mwelling/pocketbone-kicad/README.md

# pocketbone-kicad
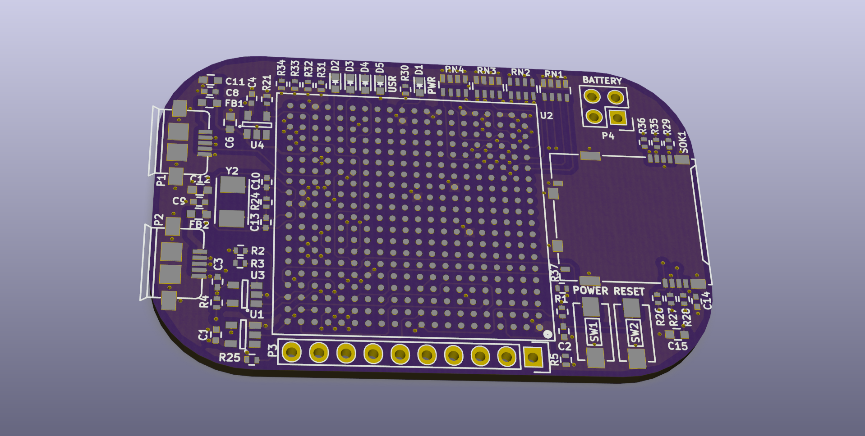
[picture p1: pocketbone-kicad.png]

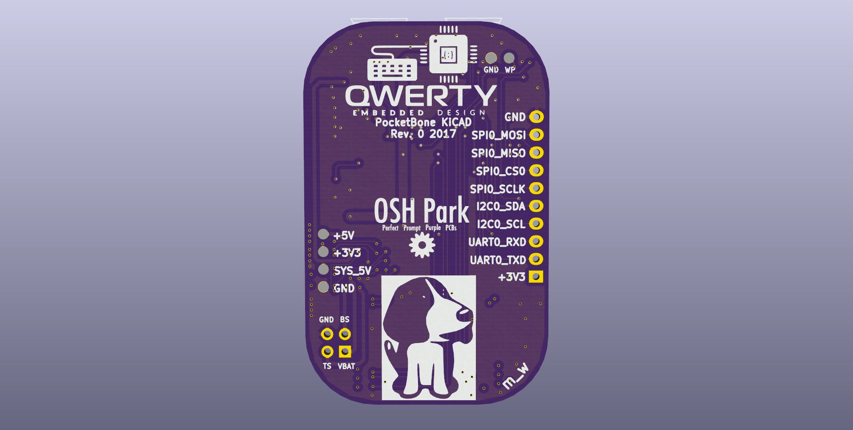
[picture p2: pocketbone-kicad-back.png]
