mwelling/pocketbone-kicad/pocketbone-kicad.pdf

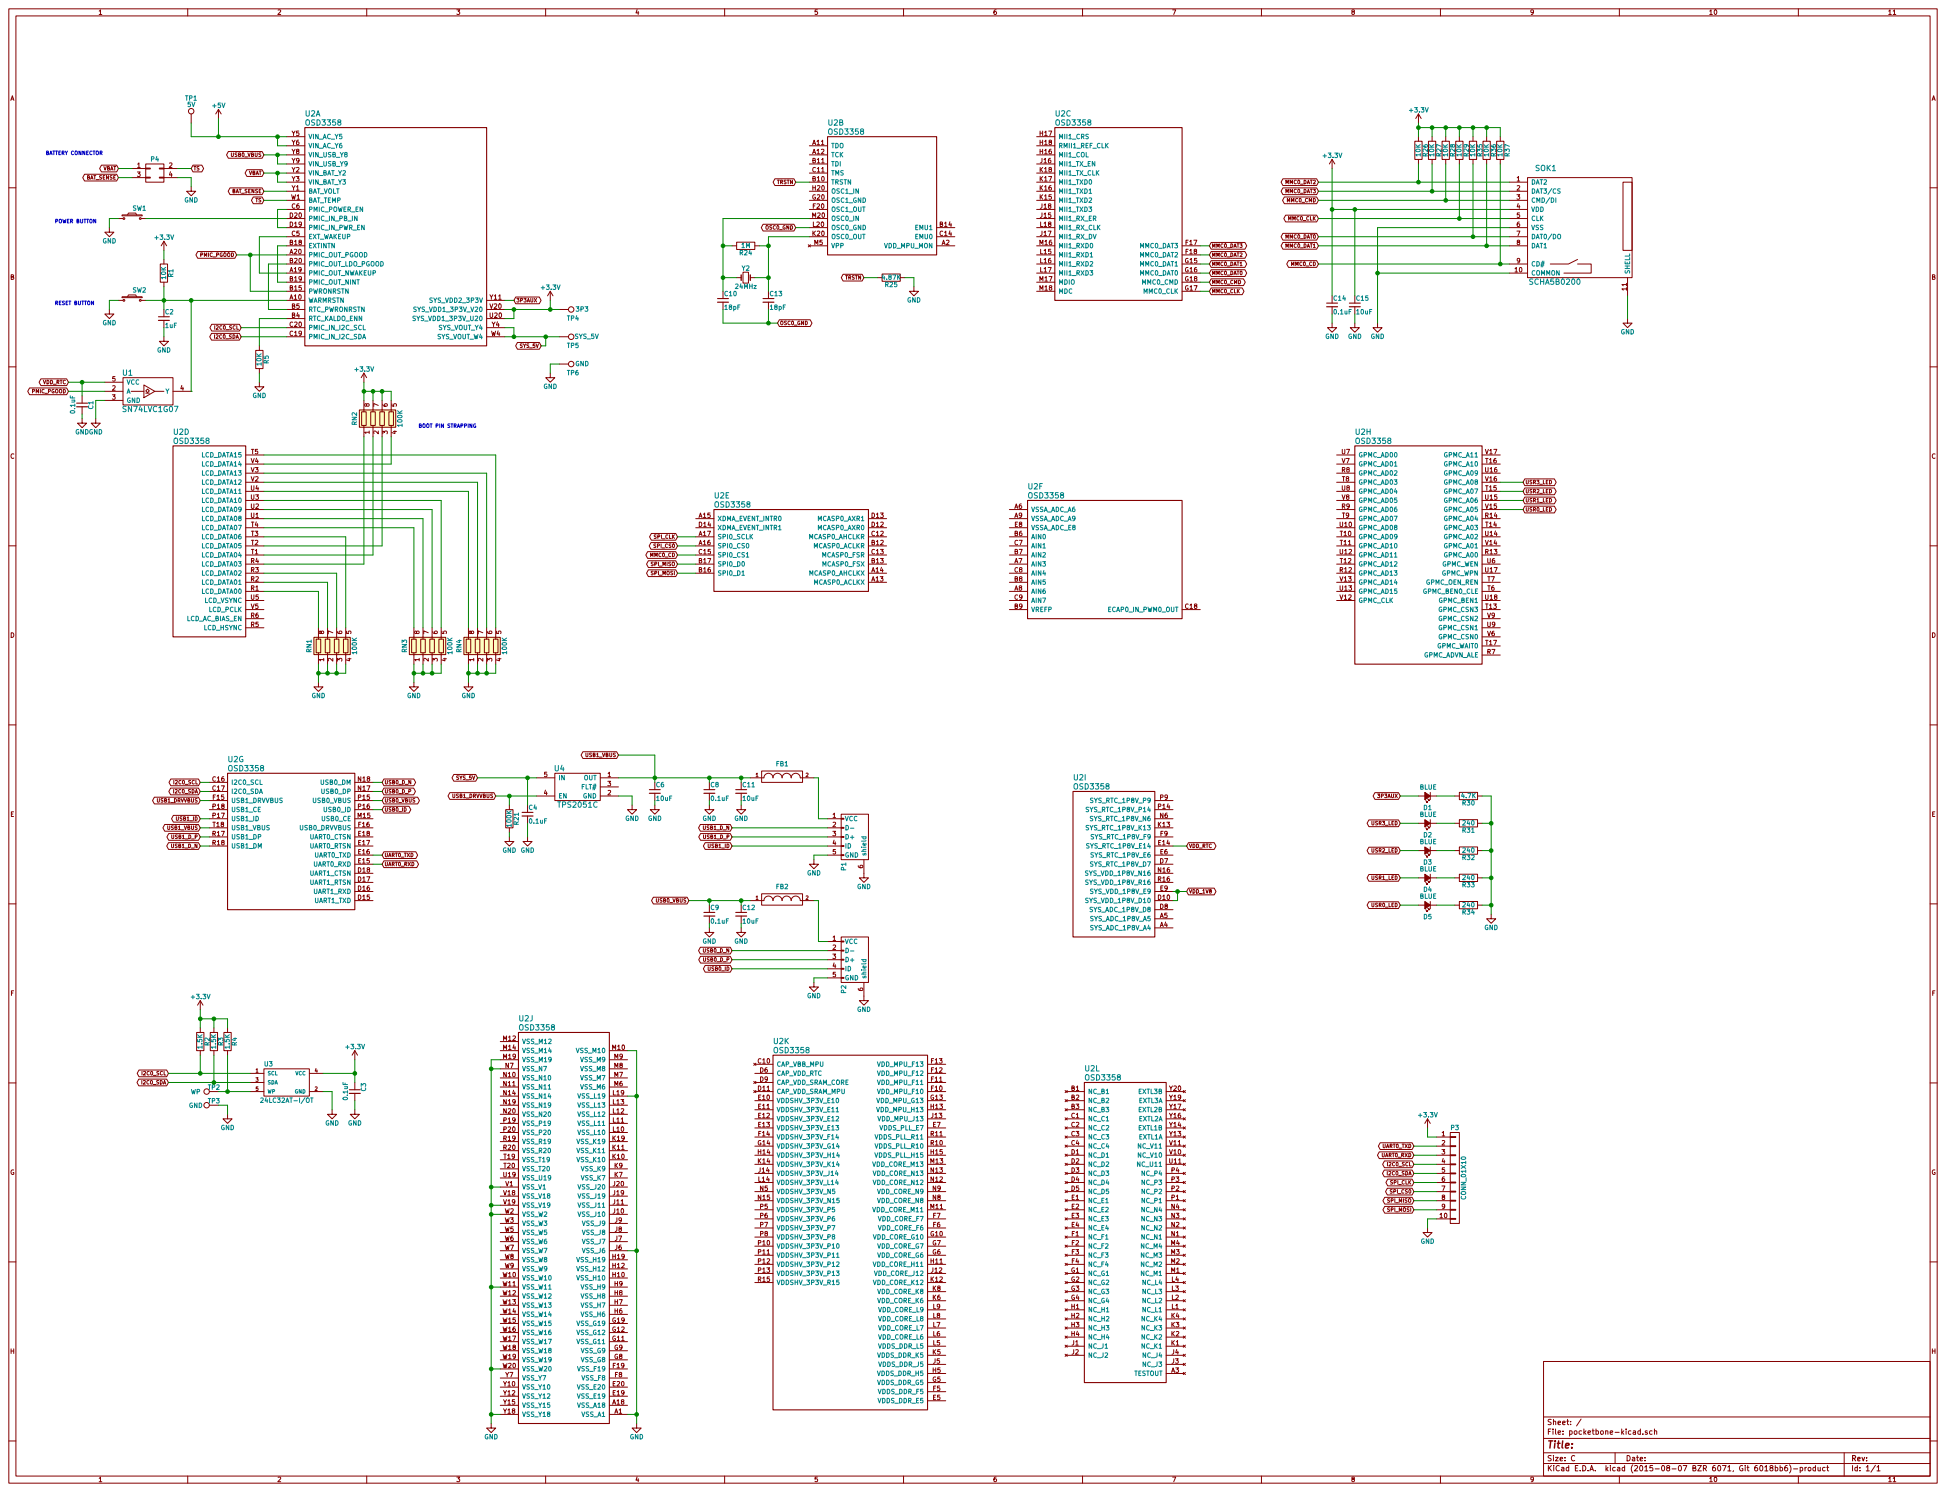
[picture p3: page 1]

File: pocketbone-kicad.sch Sheet: /
