mwelling/pocketbone-kicad/pocketbone-kicad.kicad_pcb

## KiCad design pocketbone-kicad.kicad_pcb (2017-03-28)

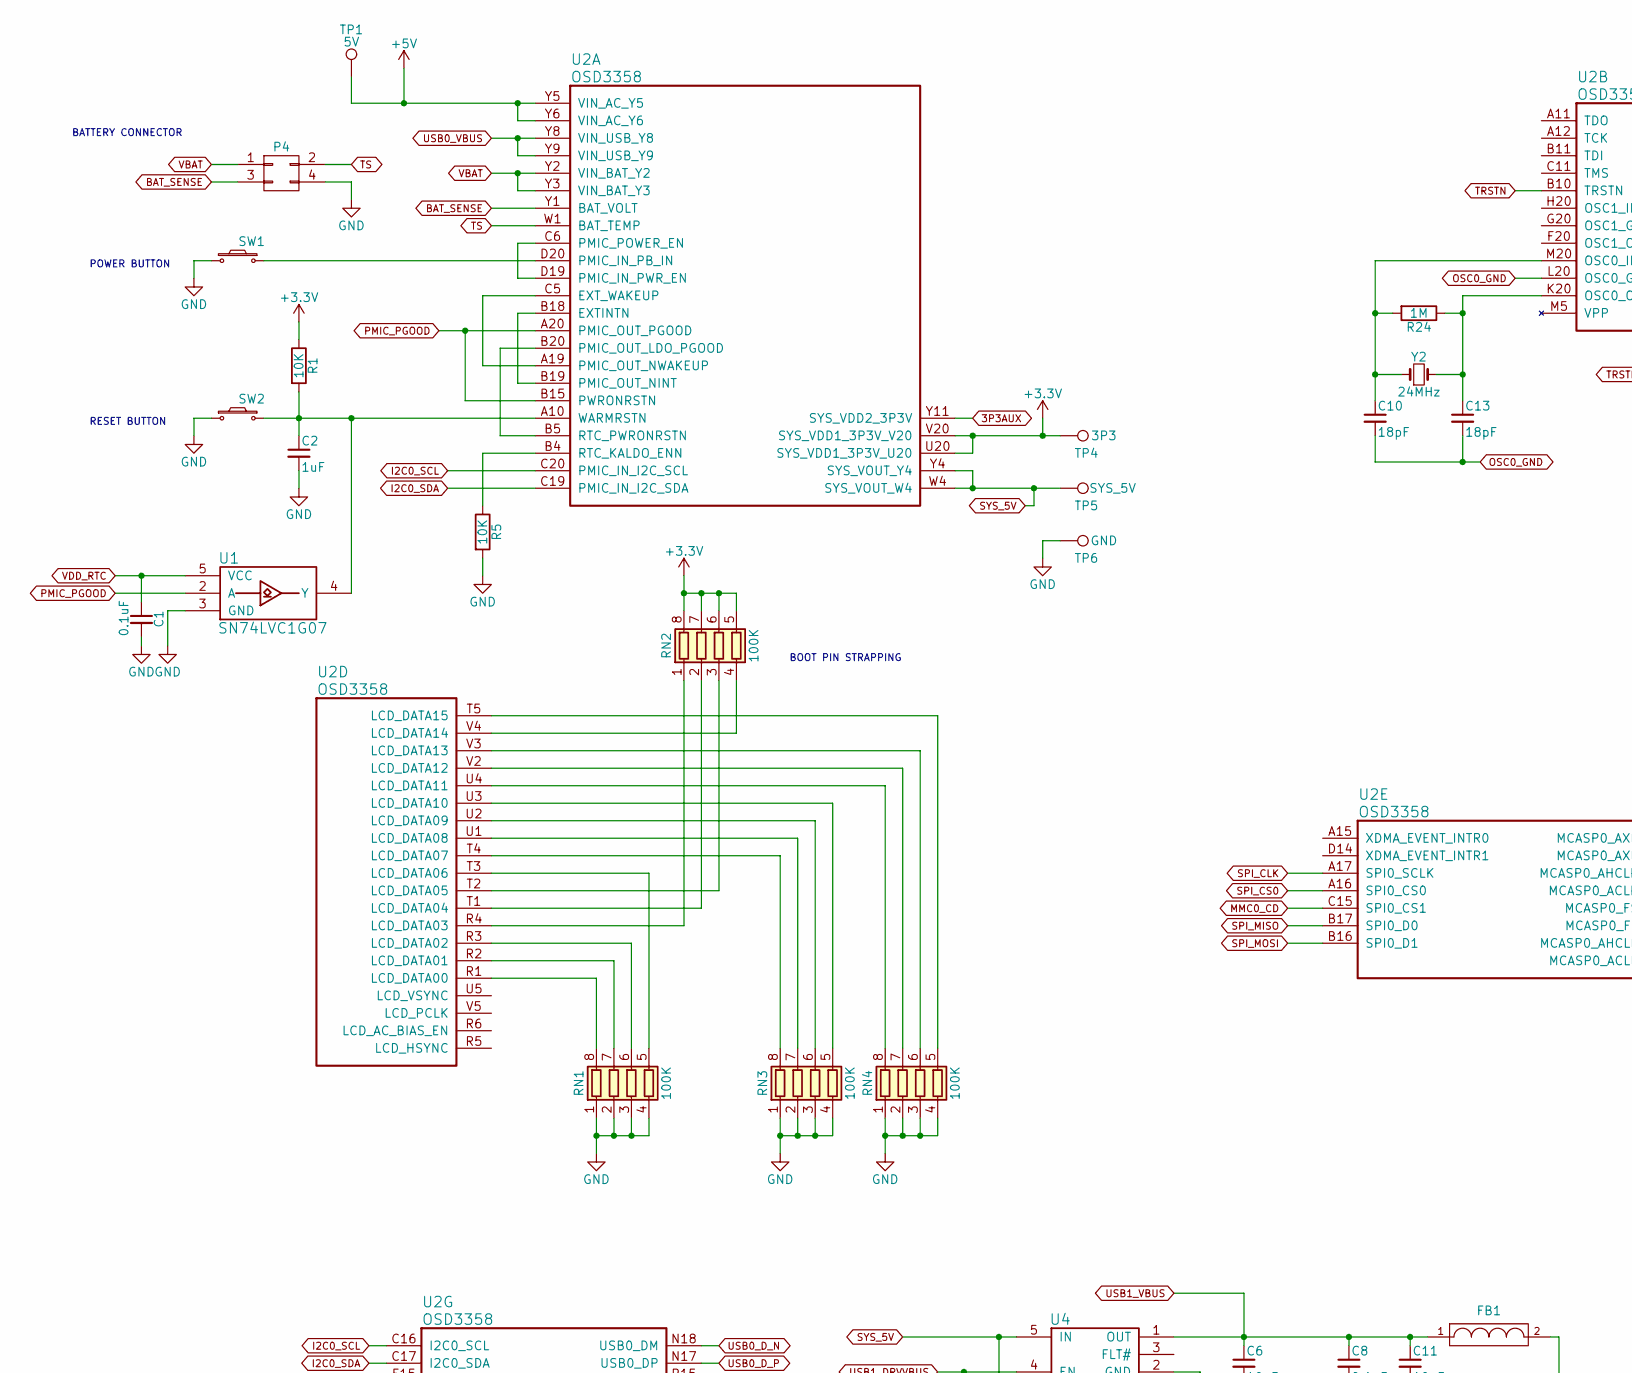
[picture p4: schematic pocketbone-kicad.sch, part in row 1, column 1]

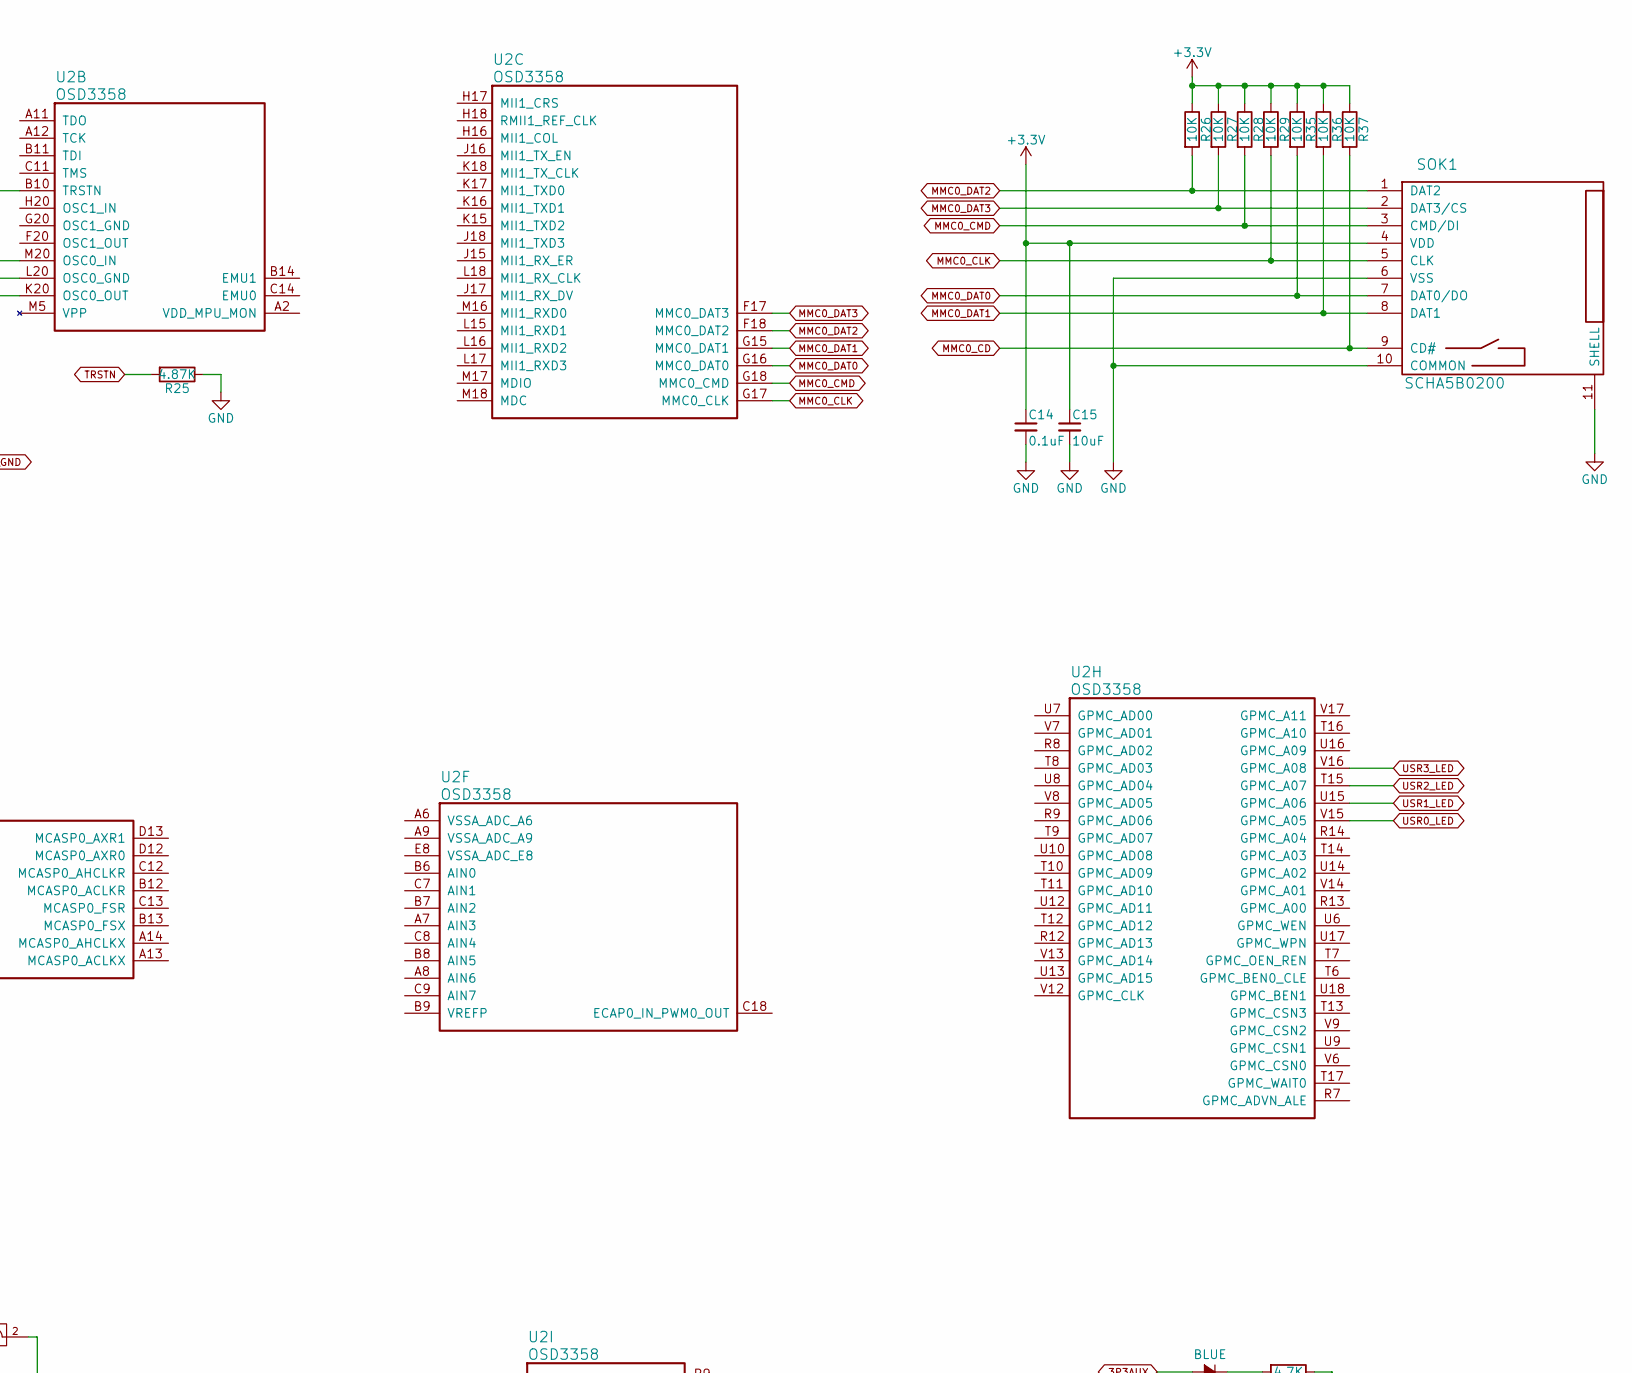
[picture p5: schematic pocketbone-kicad.sch, part in row 1, column 2]

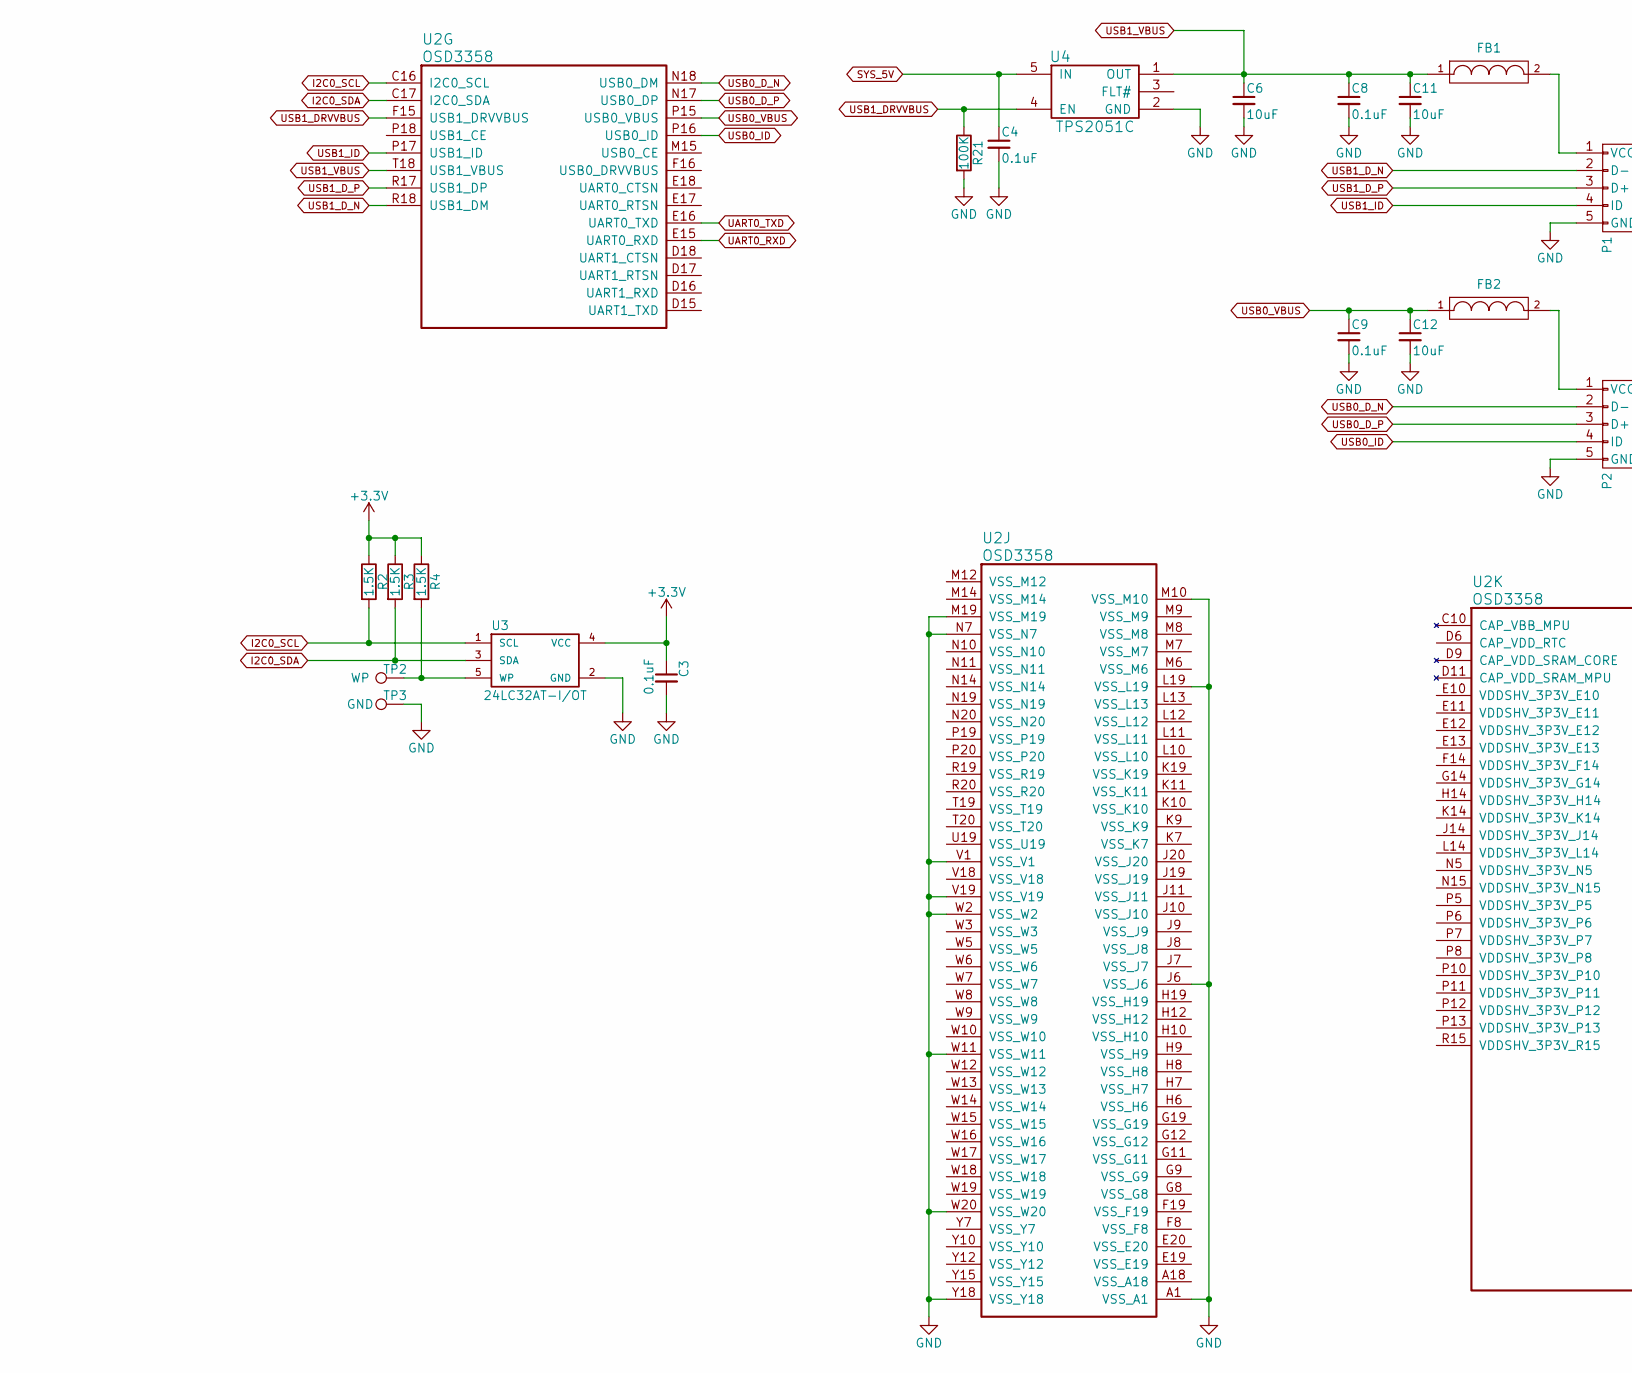
[picture p6: schematic pocketbone-kicad.sch, part in row 2, column 1]

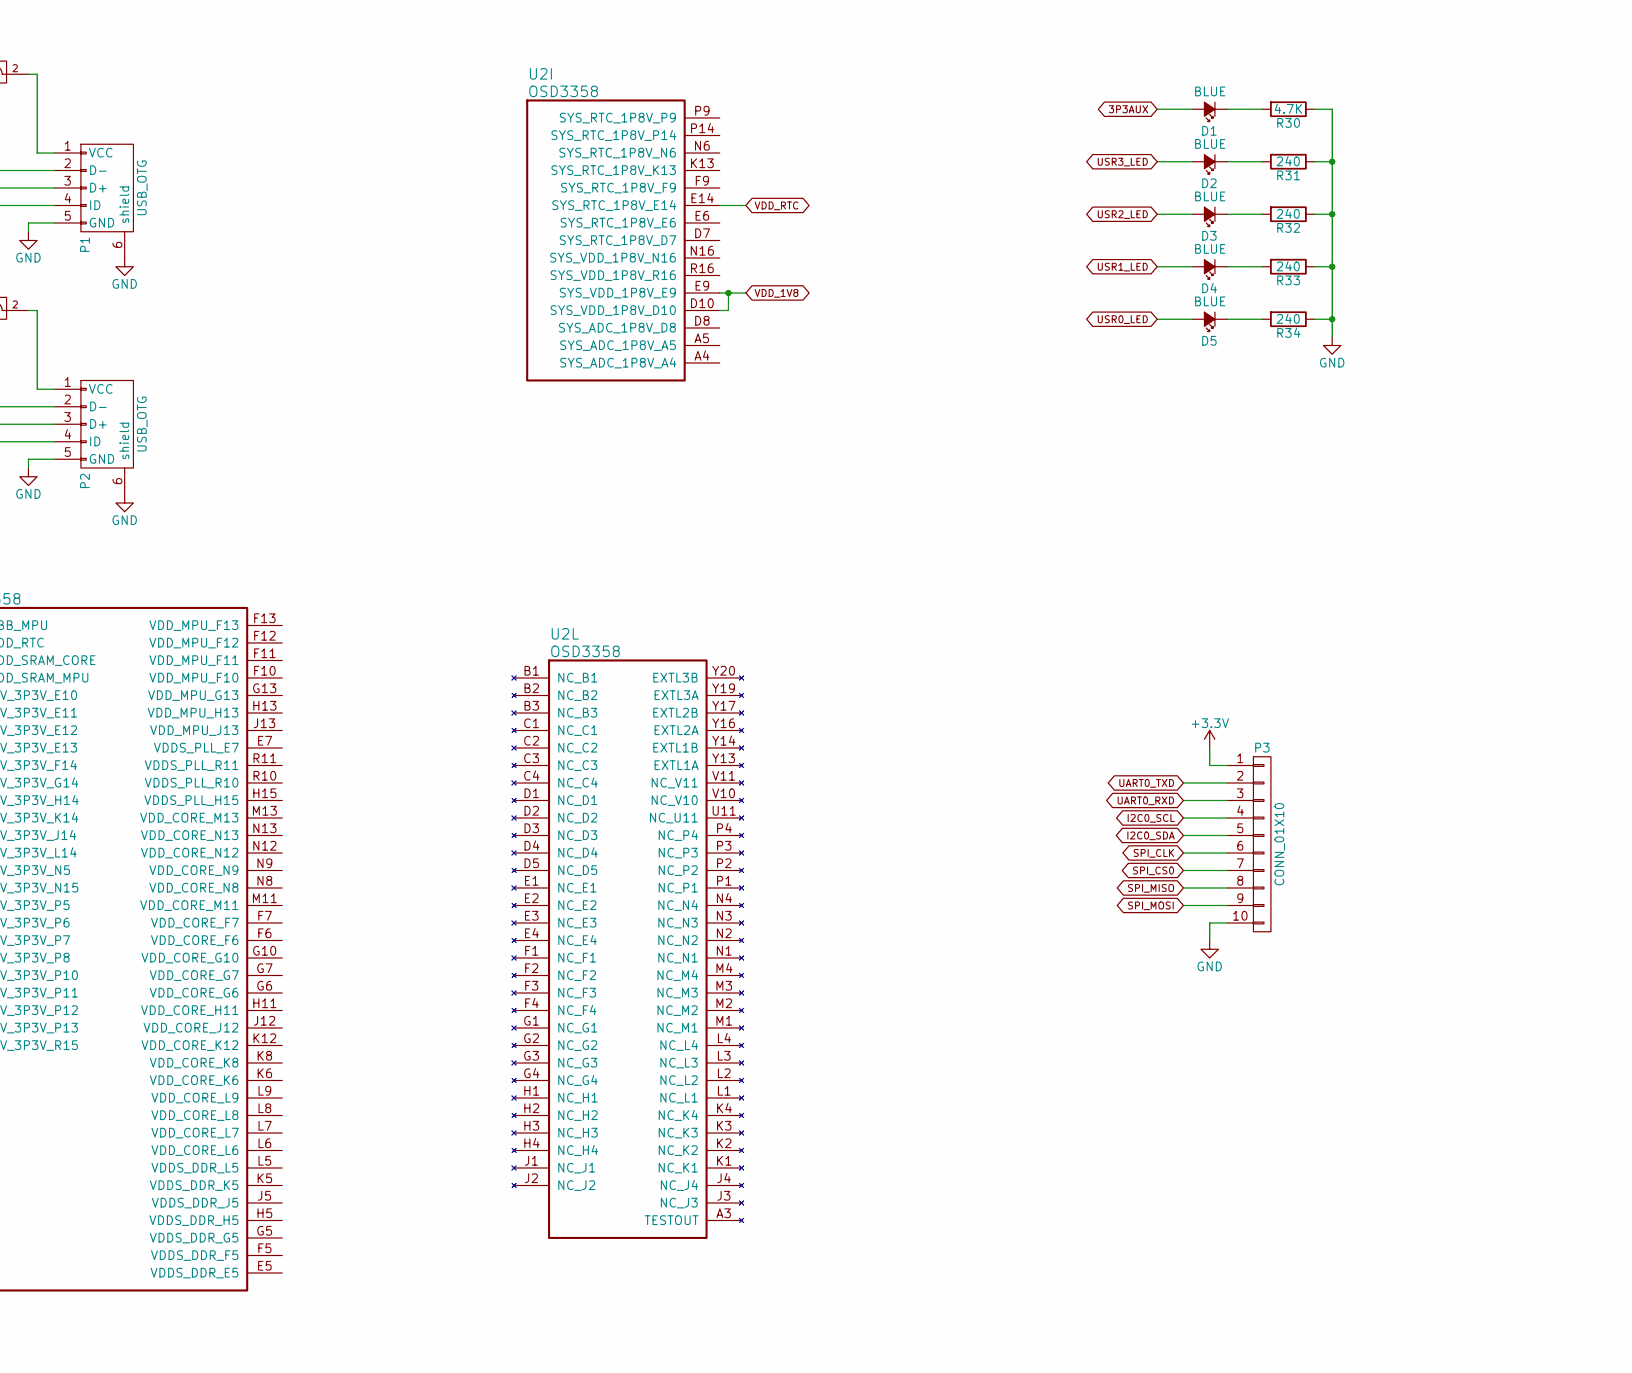
[picture p7: schematic pocketbone-kicad.sch, part in row 2, column 2]

Parts:
C1, C3, C4, C8, C9, C14: 0.1uF; C_0402
C2: 1uF; C_0402
C6, C11, C12, C15: 10uF; C_0603
C10, C13: 18pF; C_0402
D1, D2, D3, D4, D5: BLUE; LED-0603
FB1, FB2: FILTER; C_0603
P1, P2: USB_OTG; USB_MICRO_B_ST-USB-001E
P3: CONN_01X10; Socket_Strip_Straight_1x10
P4: CONN_02X02; Socket_Strip_Straight_2x02
R1, R5, R26, R27, R28, R29, R35, R36, R37: 10K; R_0402
R2, R3, R4: 1.5K; R_0402
R21: 100K; R_0402
R24: 1M; R_0402
R25: 4.87K; R_0402
R30: 4.7K; R_0402
R31, R32, R33, R34: 240; R_0402
RN1, RN2, RN3, RN4: 100K; R_Array_Concave_4x0603
SOK1: SCHA5B0200
SW1, SW2: SW_PUSH_SMALL_H; SW_SPST_EVQPE1
TP1: 5V; Measurement_Point_Round-SMD-Pad_Small
TP2: WP; Measurement_Point_Round-SMD-Pad_Small
TP3, TP6: GND; Measurement_Point_Round-SMD-Pad_Small
TP4: 3P3; Measurement_Point_Round-SMD-Pad_Small
TP5: SYS_5V; Measurement_Point_Round-SMD-Pad_Small
U1: SN74LVC1G07; SOT-23-5
U2: OSD3358; BGA-400-1-27mm
U3: 24LC32AT-I/OT; SOT-23-5
U4: TPS2051C; SOT-23-5
Y2: 24MHz; 445C33D24M00000

Connections:
3P3AUX: D1.2 (A), U2.Y11 (SYS_VDD2_3P3V)
+3V3: C3.1, C14.1, C15.1, P3.1, R1.1, R2.1, R3.1, R4.1, R26.1, R27.1, R28.1, R29.1, R35.1, R36.1, R37.1, RN2.5 (R4.2), RN2.6 (R3.2), RN2.7 (R2.2), RN2.8 (R1.2), SOK1.4 (VDD), TP4.1, U2.U20 (SYS_VDD1_3P3V_U20), U2.V20 (SYS_VDD1_3P3V_V20), U3.4 (VCC)
+5V: TP1.1, U2.Y5 (VIN_AC_Y5), U2.Y6 (VIN_AC_Y6)
BAT_SENSE: P4.3, U2.Y1 (BAT_VOLT)
GND: C1.2, C2.2, C3.2, C4.2, C6.2, C8.2, C9.2, C11.2, C12.2, C14.2, C15.2, P1.5 (GND), P1.6 (shield), P2.5 (GND), P2.6 (shield), P3.10, P4.4, R5.2, R21.2, R25.1, R30.1, R31.1, R32.1, R33.1, R34.1, RN1.1 (R1.1), RN1.2 (R2.1), RN1.3 (R3.1), RN1.4 (R4.1), RN3.1 (R1.1), RN3.2 (R2.1), RN3.3 (R3.1), RN3.4 (R4.1), RN4.1 (R1.1), RN4.2 (R2.1), RN4.3 (R3.1), RN4.4 (R4.1), SOK1.6 (VSS), SOK1.10 (COMMON), SOK1.11 (SHELL), SW1.1, SW2.1, TP3.1, TP6.1, U1.3 (GND), U2.A1 (VSS_A1), U2.J6 (VSS_J6), U2.L19 (VSS_L19), U2.M10 (VSS_M10), U2.M19 (VSS_M19), U2.N7 (VSS_N7), U2.V1 (VSS_V1), U2.V19 (VSS_V19), U2.W2 (VSS_W2), U2.W11 (VSS_W11), U2.W20 (VSS_W20), U2.Y18 (VSS_Y18), U3.2 (GND), U4.2 (GND)
I2C0_SCL: P3.4, R2.2, U2.C16 (I2C0_SCL), U2.C20 (PMIC_IN_I2C_SCL), U3.1 (SCL)
I2C0_SDA: P3.5, R3.2, U2.C17 (I2C0_SDA), U2.C19 (PMIC_IN_I2C_SDA), U3.3 (SDA)
MMC0_CD: R37.2, SOK1.9 (CD#), U2.C15 (SPI0_CS1)
MMC0_CLK: R29.2, SOK1.5 (CLK), U2.G17 (MMC0_CLK)
MMC0_CMD: R28.2, SOK1.3 (CMD/DI), U2.G18 (MMC0_CMD)
MMC0_DAT0: R35.2, SOK1.7 (DAT0/DO), U2.G16 (MMC0_DAT0)
MMC0_DAT1: R36.2, SOK1.8 (DAT1), U2.G15 (MMC0_DAT1)
MMC0_DAT2: R26.2, SOK1.1 (DAT2), U2.F18 (MMC0_DAT2)
MMC0_DAT3: R27.2, SOK1.2 (DAT3/CS), U2.F17 (MMC0_DAT3)
unnamed: C2.1, R1.2, SW2.2, U1.4 (Y), U2.A10 (WARMRSTN)
unnamed: C10.1, R24.2, U2.M20 (OSC0_IN), Y2.1
unnamed: C13.1, R24.1, U2.K20 (OSC0_OUT), Y2.2
unnamed: D1.1 (K), R30.2
unnamed: D2.1 (K), R31.2
unnamed: D3.1 (K), R32.2
unnamed: D4.1 (K), R33.2
unnamed: D5.1 (K), R34.2
unnamed: FB1.2, P1.1 (VCC)
unnamed: FB2.2, P2.1 (VCC)
unnamed: R4.2, TP2.1, U3.5 (WP)
unnamed: R5.1, U2.B4 (RTC_KALDO_ENN)
unnamed: RN1.5 (R4.2), U2.T3 (LCD_DATA06)
unnamed: RN1.6 (R3.2), U2.R3 (LCD_DATA02)
unnamed: RN1.7 (R2.2), U2.R2 (LCD_DATA01)
unnamed: RN1.8 (R1.2), U2.R1 (LCD_DATA00)
unnamed: RN2.1 (R1.1), U2.R4 (LCD_DATA03)
unnamed: RN2.2 (R2.1), U2.T1 (LCD_DATA04)
unnamed: RN2.3 (R3.1), U2.T2 (LCD_DATA05)
unnamed: RN2.4 (R4.1), U2.V4 (LCD_DATA14)
unnamed: RN3.5 (R4.2), U2.U3 (LCD_DATA10)
unnamed: RN3.6 (R3.2), U2.U2 (LCD_DATA09)
unnamed: RN3.7 (R2.2), U2.U1 (LCD_DATA08)
unnamed: RN3.8 (R1.2), U2.T4 (LCD_DATA07)
unnamed: RN4.5 (R4.2), U2.T5 (LCD_DATA15)
unnamed: RN4.6 (R3.2), U2.V3 (LCD_DATA13)
unnamed: RN4.7 (R2.2), U2.V2 (LCD_DATA12)
unnamed: RN4.8 (R1.2), U2.U4 (LCD_DATA11)
unnamed: SW1.2, U2.D20 (PMIC_IN_PB_IN)
unnamed: U2.A19 (PMIC_OUT_NWAKEUP), U2.C5 (EXT_WAKEUP)
unnamed: U2.B18 (EXTINTN), U2.B19 (PMIC_OUT_NINT)
unnamed: U2.B5 (RTC_PWRONRSTN), U2.B20 (PMIC_OUT_LDO_PGOOD)
unnamed: U2.C6 (PMIC_POWER_EN), U2.D19 (PMIC_IN_PWR_EN)
OSC0_GND: C10.2, C13.2, U2.L20 (OSC0_GND)
PMIC_PGOOD: U1.2 (A), U2.A20 (PMIC_OUT_PGOOD), U2.B15 (PWRONRSTN)
SPI_CLK: P3.6, U2.A17 (SPI0_SCLK)
SPI_CS0: P3.7, U2.A16 (SPI0_CS0)
SPI_MISO: P3.8, U2.B17 (SPI0_D0)
SPI_MOSI: P3.9, U2.B16 (SPI0_D1)
SYS_5V: C4.1, TP5.1, U2.W4 (SYS_VOUT_W4), U2.Y4 (SYS_VOUT_Y4), U4.5 (IN)
TRSTN: R25.2, U2.B10 (TRSTN)
TS: P4.2, U2.W1 (BAT_TEMP)
UART0_RXD: P3.3, U2.E15 (UART0_RXD)
UART0_TXD: P3.2, U2.E16 (UART0_TXD)
USB0_D_N: P2.2 (D-), U2.N18 (USB0_DM)
USB0_D_P: P2.3 (D+), U2.N17 (USB0_DP)
USB0_ID: P2.4 (ID), U2.P16 (USB0_ID)
USB0_VBUS: C9.1, C12.1, FB2.1, U2.P15 (USB0_VBUS), U2.Y8 (VIN_USB_Y8), U2.Y9 (VIN_USB_Y9)
USB1_DRVVBUS: R21.1, U2.F15 (USB1_DRVVBUS), U4.4 (EN)
USB1_D_N: P1.2 (D-), U2.R18 (USB1_DM)
USB1_D_P: P1.3 (D+), U2.R17 (USB1_DP)
USB1_ID: P1.4 (ID), U2.P17 (USB1_ID)
USB1_VBUS: C6.1, C8.1, C11.1, FB1.1, U2.T18 (USB1_VBUS), U4.1 (OUT)
USR0_LED: D5.2 (A), U2.V15 (GPMC_A05)
USR1_LED: D4.2 (A), U2.U15 (GPMC_A06)
USR2_LED: D3.2 (A), U2.T15 (GPMC_A07)
USR3_LED: D2.2 (A), U2.V16 (GPMC_A08)
VBAT: P4.1, U2.Y2 (VIN_BAT_Y2), U2.Y3 (VIN_BAT_Y3)
VDD_1V8: U2.D10 (SYS_VDD_1P8V_D10), U2.E9 (SYS_VDD_1P8V_E9)
VDD_RTC: C1.1, U1.5 (VCC), U2.E14 (SYS_RTC_1P8V_E14)

Notes on the sheet:
POWER BUTTON
RESET BUTTON
BOOT PIN STRAPPING
BATTERY CONNECTOR

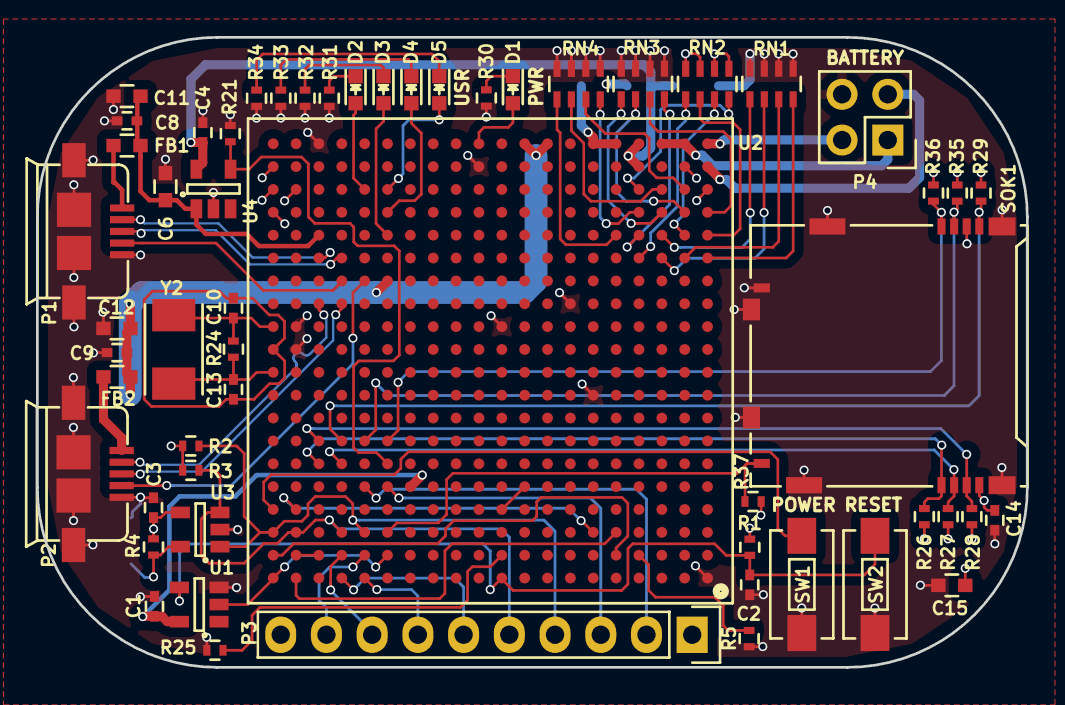
[picture p8: board pocketbone-kicad.kicad_pcb from above]

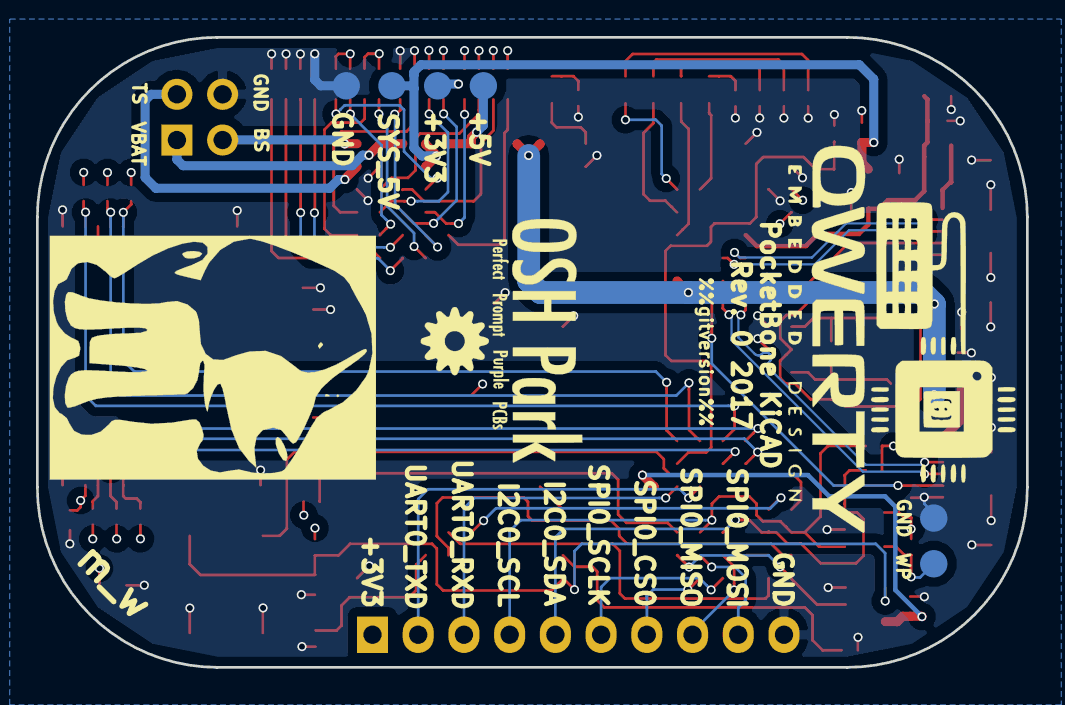
[picture p9: board pocketbone-kicad.kicad_pcb from below]

Board: 4 copper layers, 55.0 x 35.0 mm, 62 parts (6 on the bottom side), 74 nets.
