mwelling/pocketbone-kicad/(commit log)

2016-04-18 Add ground plane
    [pocketbone.brd]
2016-04-18 Consolidate library
    * Renumber parts
    [pocketbone.brd, pocketbone.sch]
2016-04-18 Update some ref designators
    [pocketbone.brd, pocketbone.sch]
2016-04-18 Rename USB connectors
    [pocketbone.brd, pocketbone.sch]
2016-04-18 Resize some silkscreen
    [pocketbone.brd, pocketbone.sch]
2016-04-18 Reposition components
    [pocketbone.brd, pocketbone.sch]
2016-04-18 Routed USB1 DP/DN
    [pocketbone.brd]
2016-04-18 Routed USB0 DP/DN
    [pocketbone.brd]
2016-04-18 New rough placement
    [pocketbone.brd, pocketbone.sch]
2016-04-18 Hack layout
    [pocketbone.brd]
2016-04-18 Adjusted resistors for 100% layout
    [pocketbone.brd]
2016-05-17 Connect microSD to 3.3V
    [pocketbone.brd, pocketbone.sch]
2016-06-01 Tent vias
    [pocketbone.brd]
2016-11-22 Add initial schematic conversion
    TODO:
    - Add buffer to drive reset with POR
    - Add header for expansion
    - Consider adding alternate power input
    [pocketbone-kicad.kicad_pcb, pocketbone-kicad.sch]
2016-11-22 Add schematic print for early review
2016-11-26 Schematic updates
    Adds microsd card
    Adds POR buffer
    Adds VBUS switch for Host mode on USB1
    [pocketbone-kicad.sch]
2016-11-26 Add updated schematic print for review
2016-11-27 Start placement of PCB
    Create footprint for microSD card.
    Choose appropriate ferrite bead footprint.
    Create footprint for crystals.
    Check patterns for all components.
    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
    [pocketbone-kicad.kicad_pcb, pocketbone-kicad.sch]
2016-11-28 Few PCB updates
    Adds pattern for SD card and 24Mhz SMD crystal.
    Removes 32.768KHz crystal from design.
    Preliminary placement done.
    Need to add test points.
    All patterns need to be verified with specific components.
    [pocketbone-kicad.kicad_pcb, pocketbone-kicad.sch]
2016-12-04 Add 10 pin IO header
    [pocketbone-kicad.sch]
2016-12-04 2 layer routing attempt
    TODO: Figure out proper USB routing with 2 layers.
    [pocketbone-kicad.kicad_pcb]
2016-12-04 Update front of board 3d image
2017-01-18 Pull back routing and update placement
    The placement and footprint updated for USB.
    TODO: Attempt single sided population.
    [pocketbone-kicad.kicad_pcb, pocketbone-kicad.sch]
2017-02-02 Many PCB updates
    Updated the placement for single sided population.
    Switched boot mode selection resistors to arrays to save space.
    Switched expansion header to .1 inch (lichen pub compatible).
    Added battery connect similar to BBB.
    [pocketbone-kicad.kicad_pcb, pocketbone-kicad.sch]
2017-02-02 Update PDF with schematic changes
2017-02-09 Routing complete
    Battery header updated in schmatic.
    Plots and pictures updated.
    Ready for design review.
    [pocketbone-kicad.kicad_pcb, pocketbone-kicad.sch]
2017-02-09 Last minute tweaks
    This version is posted to OSHpark site for anyone to order.
    Order at your own risk.
    [pocketbone-kicad.kicad_pcb, pocketbone-kicad.sch]
2017-02-10 Add OSHPark logo to the PCB and tweak the silk
    OSHPark sponsoring the first proto run. \o/
    https://oshpark.com/shared_projects/b7F6qftP
    [pocketbone-kicad.kicad_pcb]
2017-02-13 Updated Footprint and Schematic Librarys
    The Paths of the USB and SOT Footprints pointed to local Directorys on
    your HDD instead of the Project Folder
    [pocketbone-kicad.kicad_pcb, pocketbone-kicad.sch]
2017-03-01 Move EAGLE files to a subdirectory
    [pocketbone.brd, pocketbone.sch]
2017-03-01 Remove EAGLE files
    [pocketbone.brd, pocketbone.sch]
2017-03-19 o Add Python script that can generate fabbing files from the command line. o Add Makefile that makes use of it: just calling 'make' will create a zip file with the necessary layers. o Send kicad_pcb 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
    [pocketbone-kicad.kicad_pcb]
2017-03-23 o Limit changes in PCB file to only include the %%gitversion%% change.
    [pocketbone-kicad.kicad_pcb]
